MiguelGalvezChocce/Seguidor-solar-de-dos-ejes/El archivo fuente de la simulación de Proteus/Captura de pantalla de la simulación.png

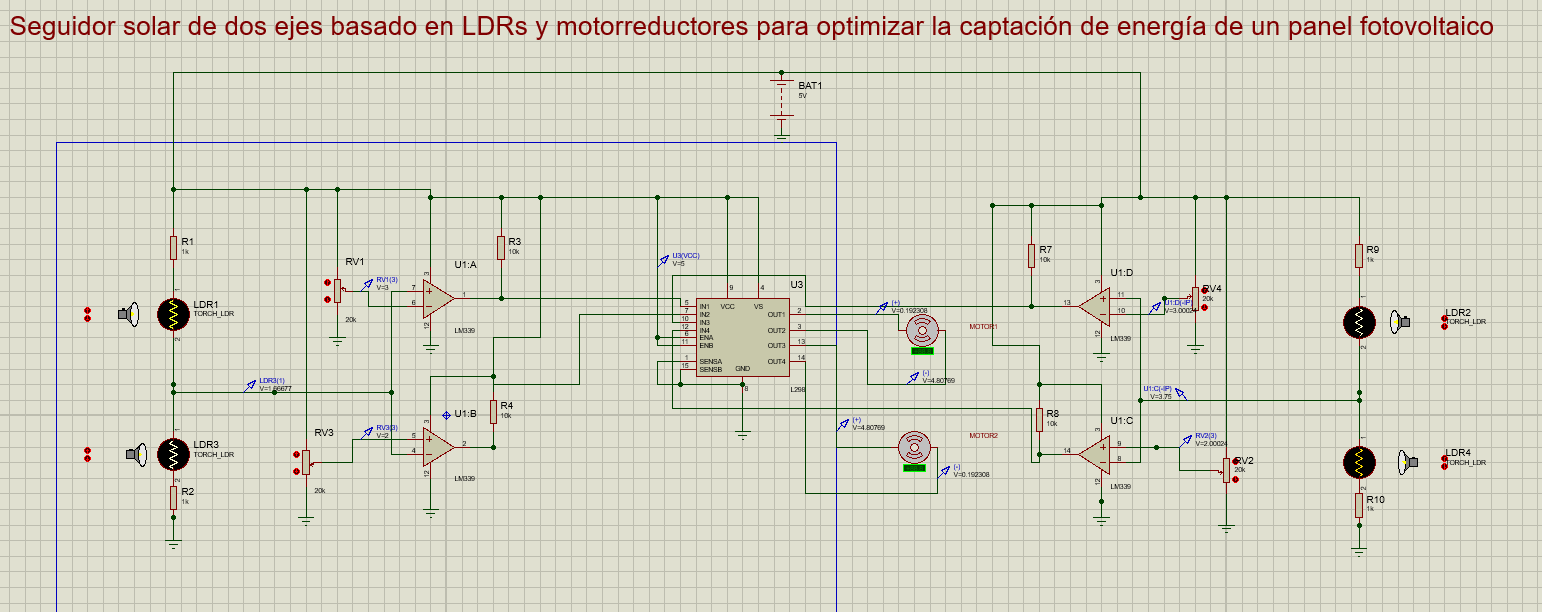
El archivo fuente de la simulación de Proteus/Captura de pantalla de la simulación.png
