MiguelGalvezChocce/Seguidor-solar-de-dos-ejes/(list of files, drawings)

Other design files:
El archivo fuente de la simulación de Proteus/SimulacionProteus.pdsprj
